revk/ESP32-GPS/PCB/Logger/production/bom.csv

Designator | Footprint | Quantity | Value | LCSC Part #
C1, C18, C26 | C_0805 | 3 | 100uF | C141660
C10, C11, C12, C13, C14, C15, C16, C17, C19, C21, C23, C24, C25, C3, C4, C6, C7, C8, C9 | C_0402 | 19 | 100nF
C2 | CP_EIA-7343-31_Kemet-D | 1 | C_Polarized | C106188
C20, C22 | C_0603 | 2 | 22uF
C5 | C_0402 | 1 | 1uF
D1, D20, D24, D3, D5, D6 | DFN1006-2L | 6 | ~ | C5137770
D10, D11, D12, D13, D14, D15, D16, D17, D18, D19, D21, D22, D23, D4, D7, D8, D9 | SMD1010 | 17 | XL-1010RGBC-WS2812B | C5349953
D2 | D_SOD-123 | 1 | MBR0530
J1 | JST_PH_S2B-PH-SM4-TB_1x02-1MP_P2.00mm_Horizontal | 1 | JST-PH-SM4-TB | C295747
J2 | USB-C-Socket-H | 1 | USB-C-Socket-V | C709357
J4 | AA-Pad | 1 | Reset
J6 | TF_PUSH | 1 | TF_PUSH | C393941
Q1, Q3 | SOT-23 | 2 | CJ2301 | C5224170
Q2 | SOT-23 | 1 | C179347 | C3034
R1, R15, R16, R17, R18, R19, R20, R4, R5, R6 | R_0402 | 10 | 10K
R10 | R_1218 | 1 | 1R 1W | C175540
R11, R7, R8, R9 | R_0402 | 4 | 100K 1% | C5139597
R2, R3 | R_0402 | 2 | 5K1
U1 | ESP32-S3-MINI-1 | 1 | ESP32-S3-MINI-1 | C3013941
U2 | LGA-16_3x3mm_P0.5mm_LayoutBorder3x5y | 1 | ~ | C15134
U3 | SOT-23-5 | 1 | TP4054 | C668215
U4 | SOT-23-5 | 1 | ME6211C33M5G-N | C82942
