revk/ESP32-GPS/PCB/L86/L86.stl

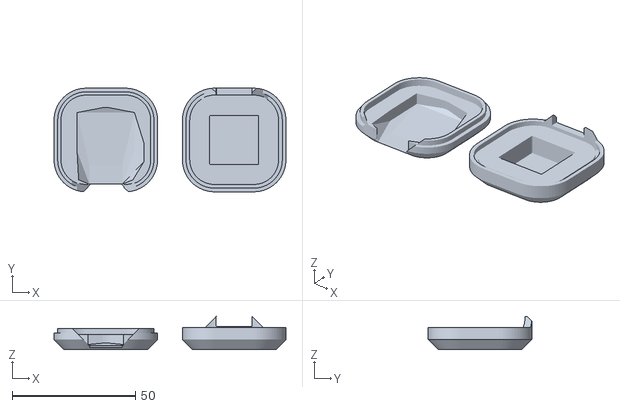
[picture p2: CAD file, 2024-01-20]
PCB/L86/L86.stl
94.0 x 42.0 x 13.4
