revk/ESP32-GPS/PCB/Logger/Logger.stl

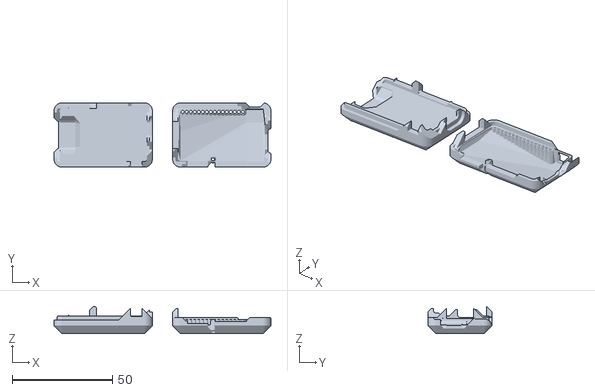
[picture p3: CAD file, 2024-01-20]
PCB/Logger/Logger.stl
108.0 x 32.0 x 13.6
