revk/ESP32-GPS/PCB/Logger/Logger.kicad_pcb

## KiCad design PCB/Logger/Logger.kicad_pcb (2026-02-13)

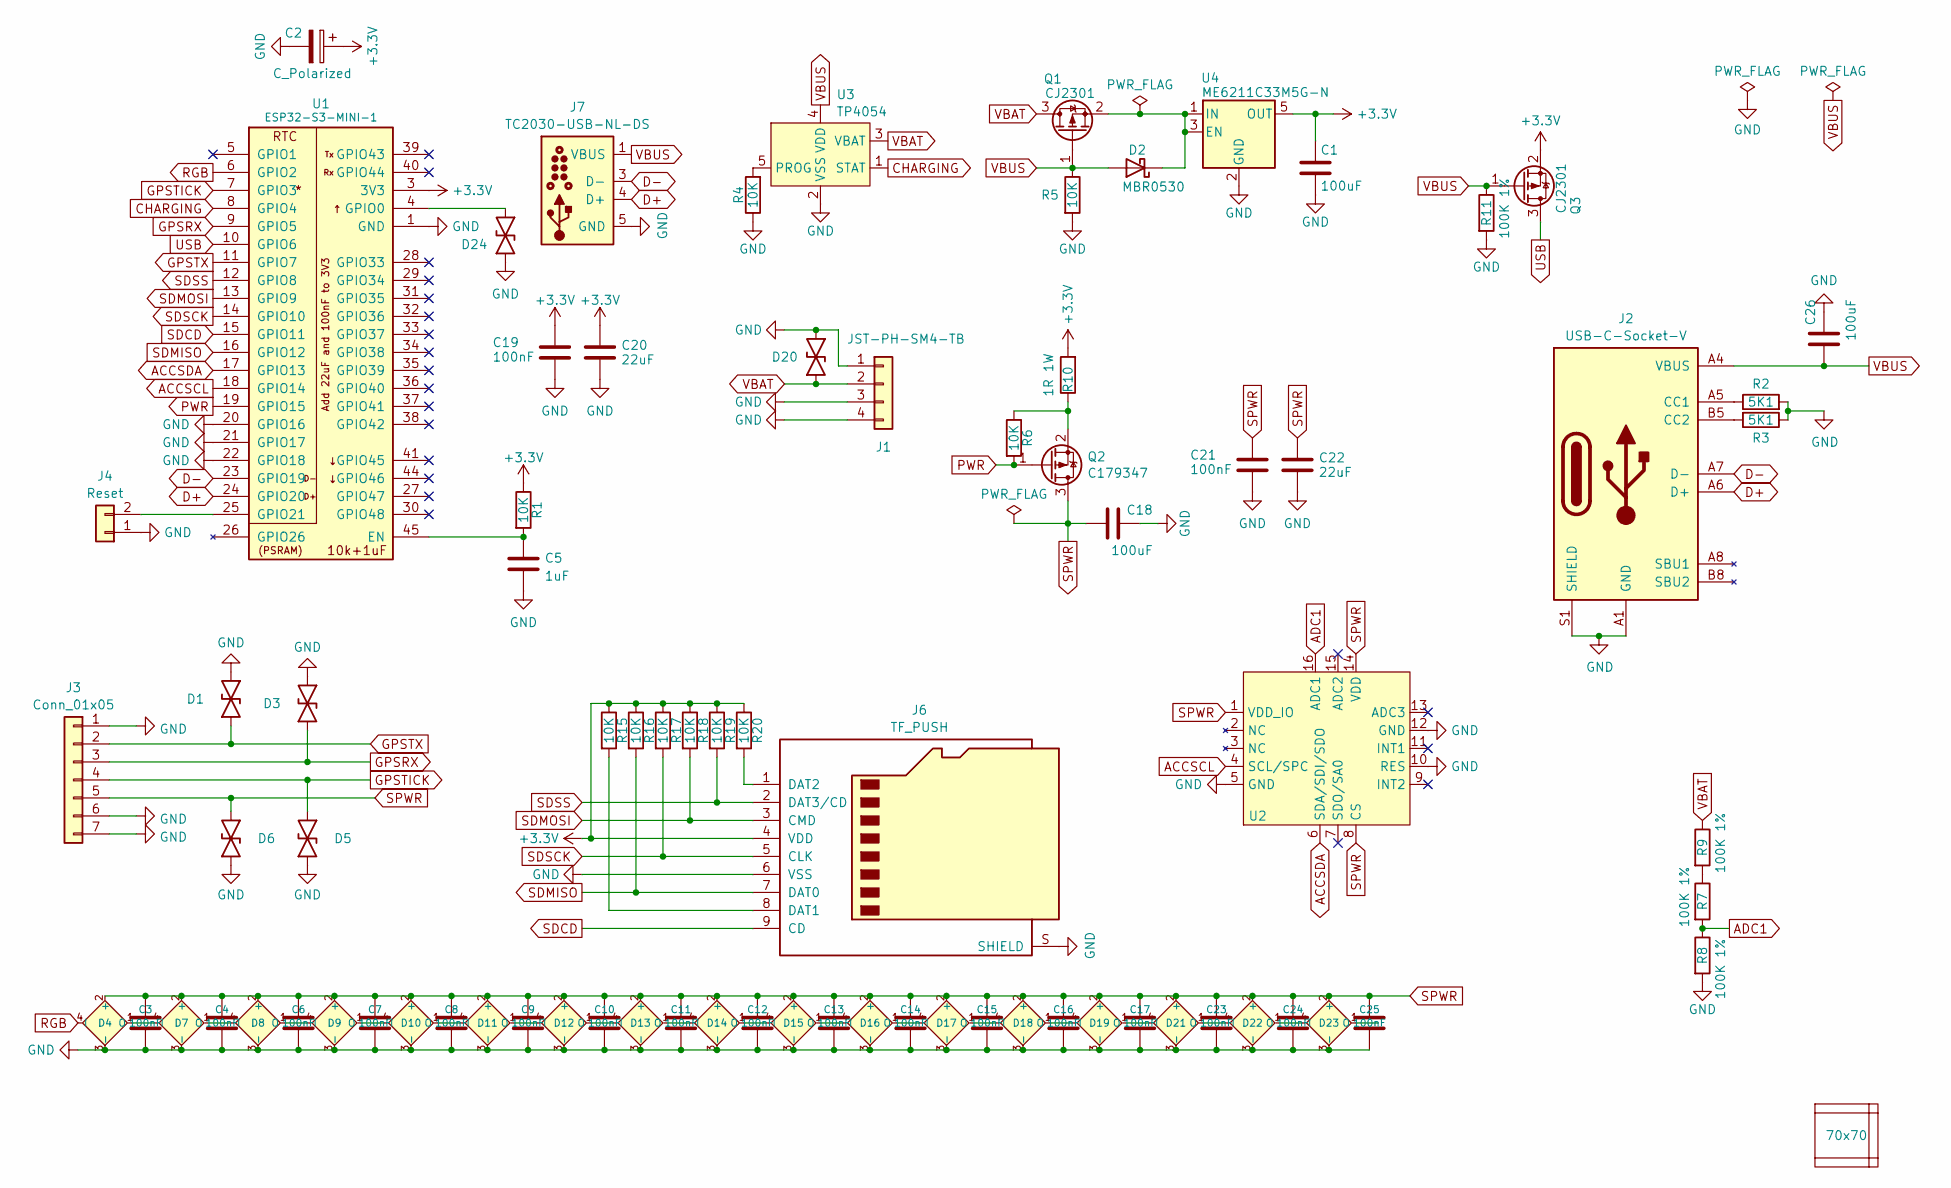
[picture p4: schematic Logger.kicad_sch, GPS reference]

Parts:
C1, C18, C26: 100uF; C_0805; MPN C141660
C2: C_Polarized; CP_EIA-7343-31_Kemet-D; MPN C106188
C3, C4, C6, C7, C8, C9, C10, C11, C12, C13, C14, C15, C16, C17, C19, C21, C23, C24, C25: 100nF; C_0402
C5: 1uF; C_0402
C20, C22: 22uF; C_0603
D1, D3, D5, D6, D20, D24: DFN1006-2L; MPN C5137770
D2: MBR0530; D_SOD-123; MPN C5204746
D4, D7, D8, D9, D10, D11, D12, D13, D14, D15, D16, D17, D18, D19, D21, D22, D23: XL-1010RGBC-WS2812B; SMD1010; MPN C5349953
J1: JST-PH-SM4-TB; JST_PH_S2B-PH-SM4-TB_1x02-1MP_P2.00mm_Horizontal; MPN C295747
J2: USB-C-Socket-V; USB-C-Socket-H; MPN C709357
J3: Conn_01x05; PTSM-HH-5-RA-SMD; Part Name PTSM 0,5/ 5-HH0-2,5-SMD WH R32
J4: Reset; AA-Pad
J6: TF_PUSH; MPN C393941
J7: TC2030-USB-NL-DS; Tag-Connect_TC2030-IDC-NL_2x03_P1.27mm_Vertical
PCB1: 70x70; PCB7070
Q1, Q3: CJ2301; SOT-23; MPN C5224170
Q2: C179347; SOT-23; MPN C3034
R1, R4, R5, R6, R15, R16, R17, R18, R19, R20: 10K; R_0402
R2, R3: 5K1; R_0402
R7, R8, R9, R11: 100K 1%; R_0402; MPN C5139597
R10: 1R 1W; R_1218; MPN C175540
U1: ESP32-S3-MINI-1; MPN C3013941
U2: LGA-16_3x3mm_P0.5mm_LayoutBorder3x5y; MPN C15134
U3: TP4054; SOT-23-5; MPN C668215
U4: ME6211C33M5G-N; SOT-23-5; MPN C82942
V1, V2, V4: VCUT70N

Connections:
+3.3V: C1.1, C2.1, C19.1, C20.1, J6.4 (VDD), Q3.2 (S), R1.1, R10.2, R15.1, R16.1, R17.1, R18.1, R19.1, R20.1, U1.3 (3V3), U4.5 (OUT)
ACCSCL: U1.18 (GPIO14), U2.4 (SCL/SPC)
ACCSDA: U1.17 (GPIO13), U2.6 (SDA/SDI/SDO)
ADC1: R7.2, R8.1, U2.16 (ADC1)
CHARGING: U1.8 (GPIO4), U3.1 (STAT)
D+: J2.A6 (D+), J2.B6 (D+), J7.4 (D+), U1.24 (GPIO20)
D-: J2.A7 (D-), J2.B7 (D-), J7.3 (D-), U1.23 (GPIO19)
GND: C1.2, C2.2, C3.2, C4.2, C5.2, C6.2, C7.2, C8.2, C9.2, C10.2, C11.2, C12.2, C13.2, C14.2, C15.2, C16.2, C17.2, C18.2, C19.2, C20.2, C21.2, C22.2, C23.2, C24.2, C25.2, C26.2, D1.1, D3.1, D4.3 (-), D5.1, D6.1, D7.3 (-), D8.3 (-), D9.3 (-), D10.3 (-), D11.3 (-), D12.3 (-), D13.3 (-), D14.3 (-), D15.3 (-), D16.3 (-), D17.3 (-), D18.3 (-), D19.3 (-), D20.1, D21.3 (-), D22.3 (-), D23.3 (-), D24.2, J1.1, J1.3, J1.4, J2.A1 (GND), J2.A12 (GND), J2.B1 (GND), J2.B12 (GND), J2.S1 (SHIELD), J3.1, J3.6, J3.7, J4.1, J6.6 (VSS), J6.S (SHIELD), J7.5 (GND), J7.6 (GND), R2.2, R3.1, R4.1, R5.2, R8.2, R11.2, U1.1 (GND), U1.2 (GND), U1.20 (GPIO16), U1.21 (GPIO17), U1.22 (GPIO18), U1.42 (GND), U1.43 (GND), U1.46 (GND), U1.47 (GND), U1.48 (GND), U1.49 (GND), U1.50 (GND), U1.51 (GND), U1.52 (GND), U1.53 (GND), U1.54 (GND), U1.55 (GND), U1.56 (GND), U1.57 (GND), U1.58 (GND), U1.59 (GND), U1.60 (GND), U1.61 (GND), U1.62 (GND), U1.63 (GND), U1.64 (GND), U1.65 (GND), U2.5 (GND), U2.10 (RES), U2.12 (GND), U3.2 (VSS), U4.2 (GND)
GPSRX: D3.2, J3.3, U1.9 (GPIO5)
GPSTICK: D5.2, J3.4, U1.7 (GPIO3)
GPSTX: D1.2, J3.2, U1.11 (GPIO7)
unnamed: D2.1 (K), Q1.2 (S), U4.1 (IN), U4.3 (EN)
unnamed: D4.1 (O), D7.4 (I)
unnamed: D7.1 (O), D8.4 (I)
unnamed: D8.1 (O), D9.4 (I)
unnamed: D9.1 (O), D10.4 (I)
unnamed: D10.1 (O), D11.4 (I)
unnamed: D11.1 (O), D12.4 (I)
unnamed: D12.1 (O), D13.4 (I)
unnamed: D13.1 (O), D14.4 (I)
unnamed: D14.1 (O), D15.4 (I)
unnamed: D15.1 (O), D16.4 (I)
unnamed: D16.1 (O), D17.4 (I)
unnamed: D17.1 (O), D18.4 (I)
unnamed: D18.1 (O), D19.4 (I)
unnamed: D19.1 (O), D21.4 (I)
unnamed: D21.1 (O), D22.4 (I)
unnamed: D22.1 (O), D23.4 (I)
unnamed: J2.A5 (CC1), R2.1
unnamed: J2.B5 (CC2), R3.2
unnamed: J4.2, U1.25 (GPIO21)
unnamed: J6.8 (DAT1), R15.2
unnamed: J6.1 (DAT2), R20.2
unnamed: Q2.2 (S), R6.1, R10.1
unnamed: R7.1, R9.2
unnamed: C5.1, R1.2, U1.45 (EN)
unnamed: D24.1, U1.4 (GPIO0)
unnamed: R4.2, U3.5 (PROG)
PWR: Q2.1 (G), R6.2, U1.19 (GPIO15)
RGB: D4.4 (I), U1.6 (GPIO2)
SDCD: J6.9 (CD), U1.15 (GPIO11)
SDMISO: J6.7 (DAT0), R16.2, U1.16 (GPIO12)
SDMOSI: J6.3 (CMD), R18.2, U1.13 (GPIO9)
SDSCK: J6.5 (CLK), R17.2, U1.14 (GPIO10)
SDSS: J6.2 (DAT3/CD), R19.2, U1.12 (GPIO8)
SPWR: C3.1, C4.1, C6.1, C7.1, C8.1, C9.1, C10.1, C11.1, C12.1, C13.1, C14.1, C15.1, C16.1, C17.1, C18.1, C21.1, C22.1, C23.1, C24.1, C25.1, D4.2 (+), D6.2, D7.2 (+), D8.2 (+), D9.2 (+), D10.2 (+), D11.2 (+), D12.2 (+), D13.2 (+), D14.2 (+), D15.2 (+), D16.2 (+), D17.2 (+), D18.2 (+), D19.2 (+), D21.2 (+), D22.2 (+), D23.2 (+), J3.5, Q2.3 (D), U2.1 (VDD_IO), U2.8 (CS), U2.14 (VDD)
USB: Q3.3 (D), U1.10 (GPIO6)
VBAT: D20.2, J1.2, Q1.3 (D), R9.1, U3.3 (VBAT)
VBUS: C26.1, D2.2 (A), J2.A4 (VBUS), J2.A9 (VBUS), J2.B4 (VBUS), J2.B9 (VBUS), J7.1 (VBUS), J7.2 (VBUS), Q1.1 (G), Q3.1 (G), R5.1, R11.1, U3.4 (VDD)

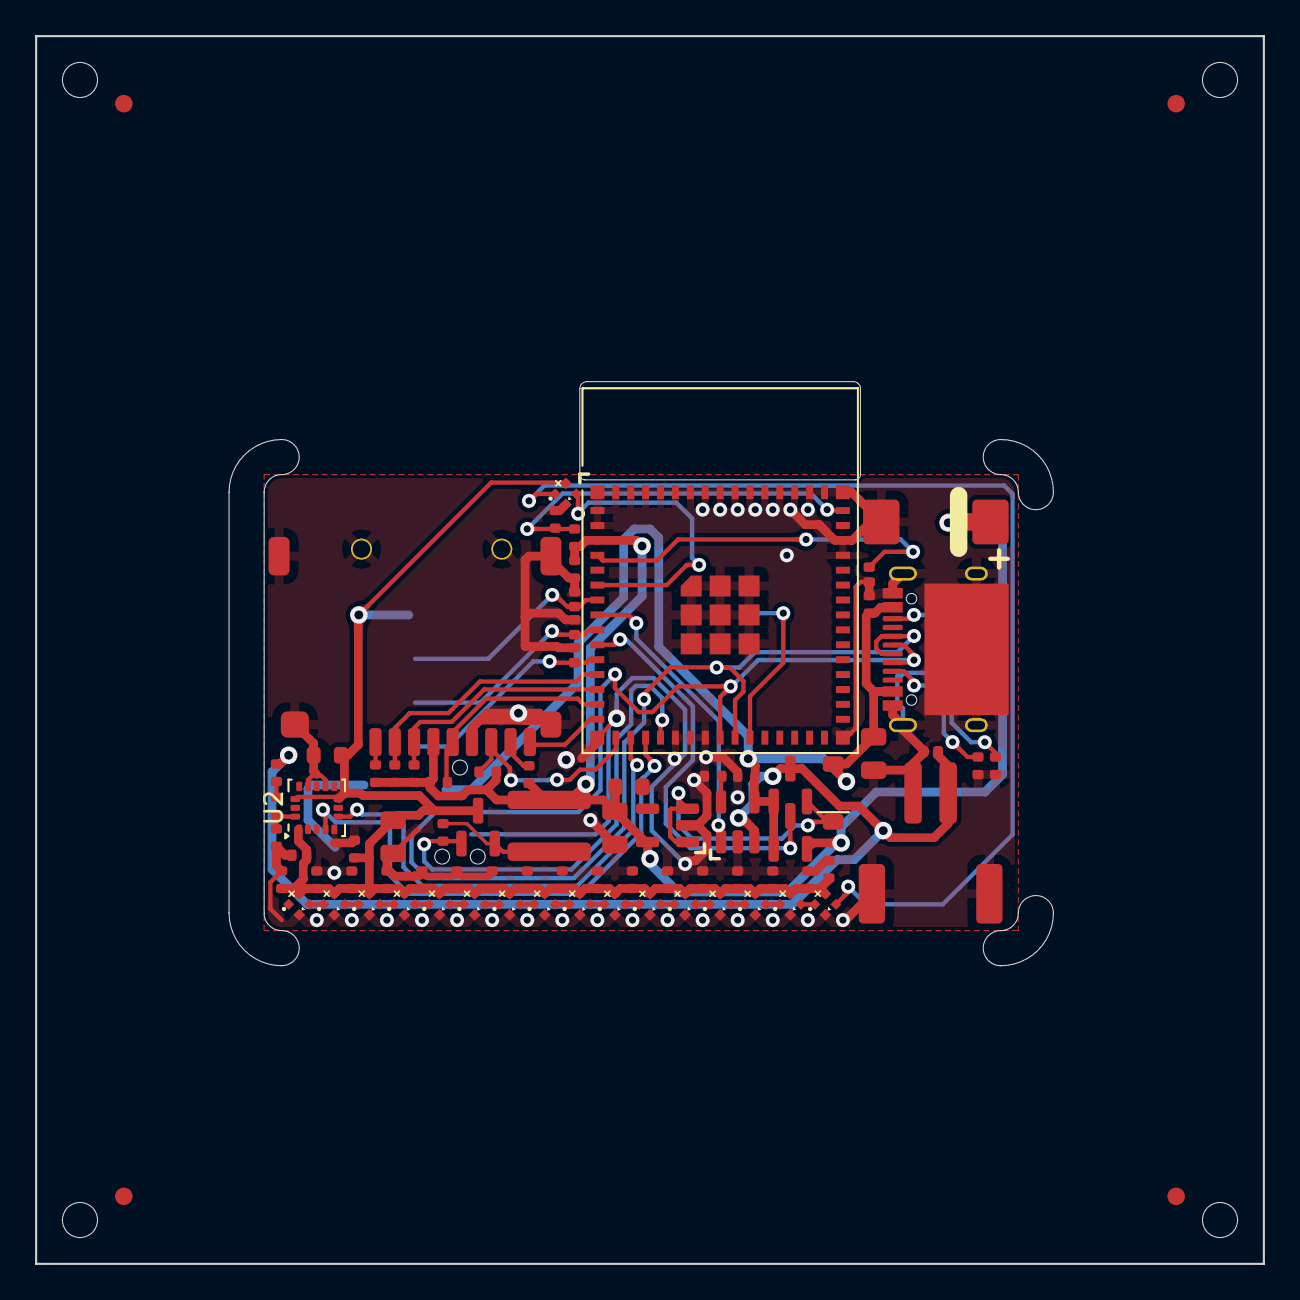
[picture p5: board Logger.kicad_pcb from above]

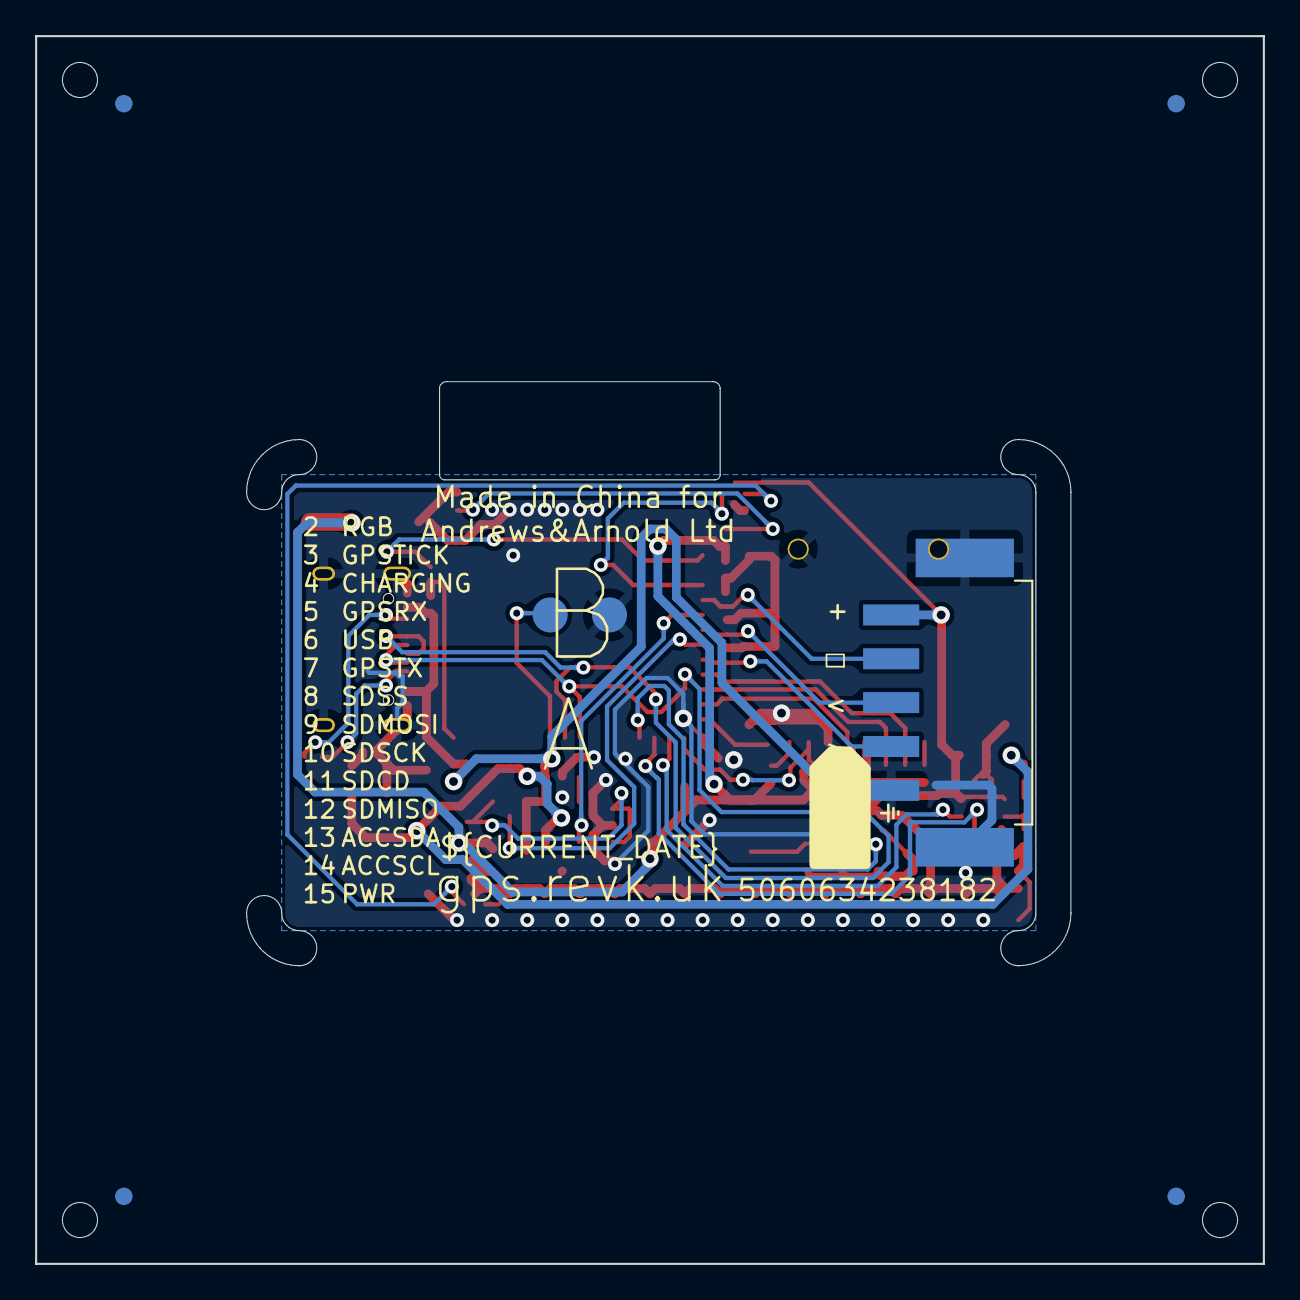
[picture p6: board Logger.kicad_pcb from below]

Board: 2 copper layers, 70.0 x 70.0 mm, 84 parts (4 on the bottom side), 49 nets.
