revk/ESP32-GPS/PCB/L86/L86.kicad_pcb

## KiCad design PCB/L86/L86.kicad_pcb (2026-02-13)

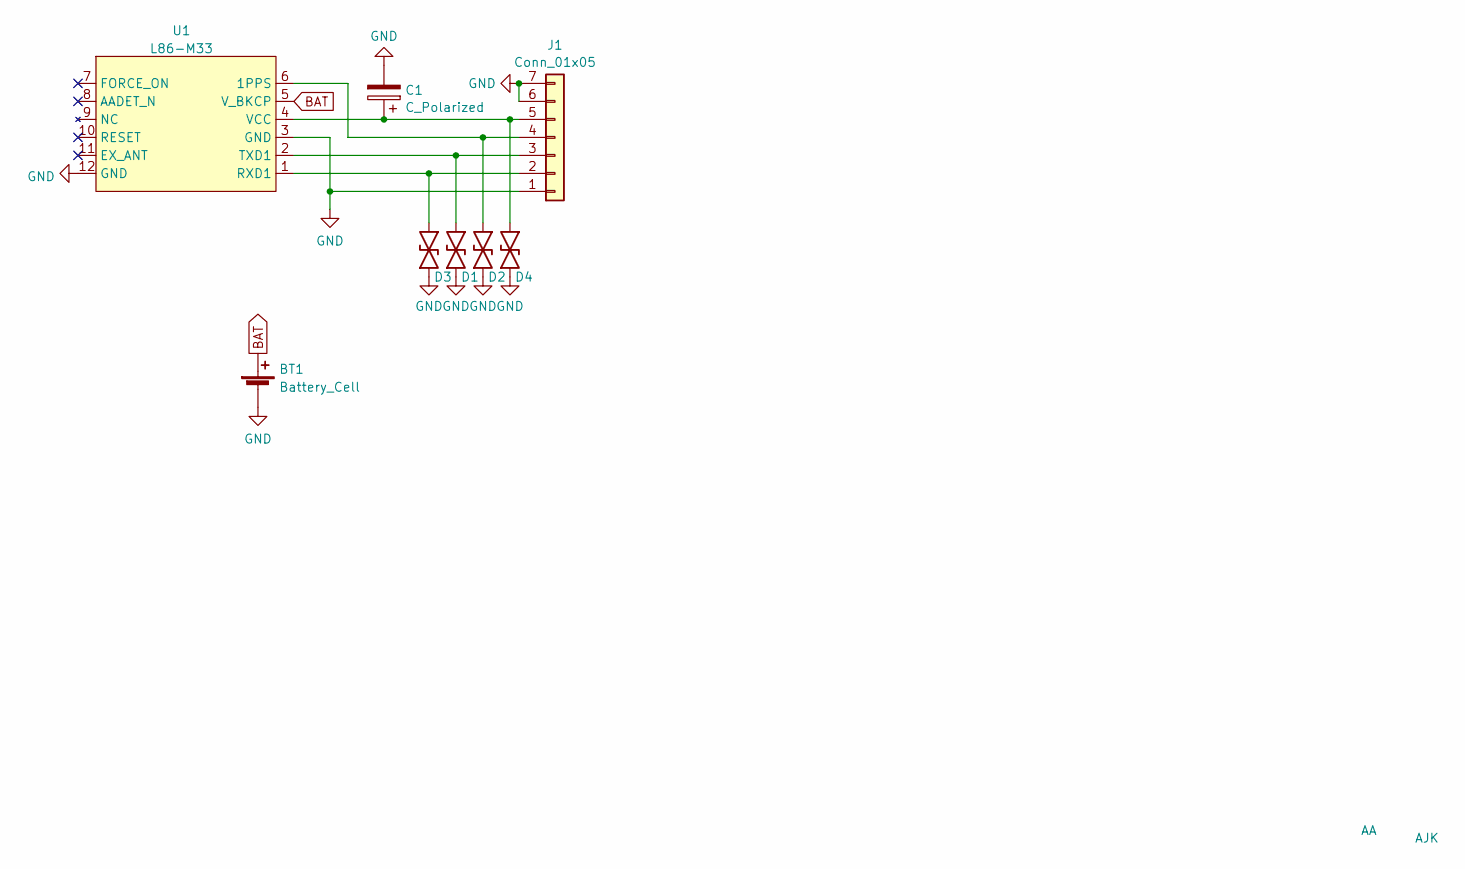
[picture p7: schematic L86.kicad_sch, GPS reference]

Parts:
BT1: Battery_Cell; Battery-Holder-2032
C1: C_Polarized; CP_EIA-7343-31_Kemet-D; MPN C106188
D1, D2, D3, D4: DFN1006-2L; MPN C5137770
J1: Conn_01x05; PTSM-HH-5-RA-P-SMD; Part name PTSM 0,5/ 5-HHI0-2,5SMDWH
Logo1: AA
Logo2: AJK
U1: L86-M33

Connections:
BAT: BT1.1 (+), U1.5 (V_BKCP)
GND: BT1.2 (-), C1.2, D1.2, D2.2, D3.2, D4.2, J1.1, J1.6, J1.7, U1.3 (GND), U1.12 (GND)
unnamed: D3.1, J1.2, U1.1 (RXD1)
unnamed: D1.1, J1.3, U1.2 (TXD1)
unnamed: D2.1, J1.4, U1.6 (1PPS)
unnamed: C1.1, D4.1, J1.5, U1.4 (VCC)

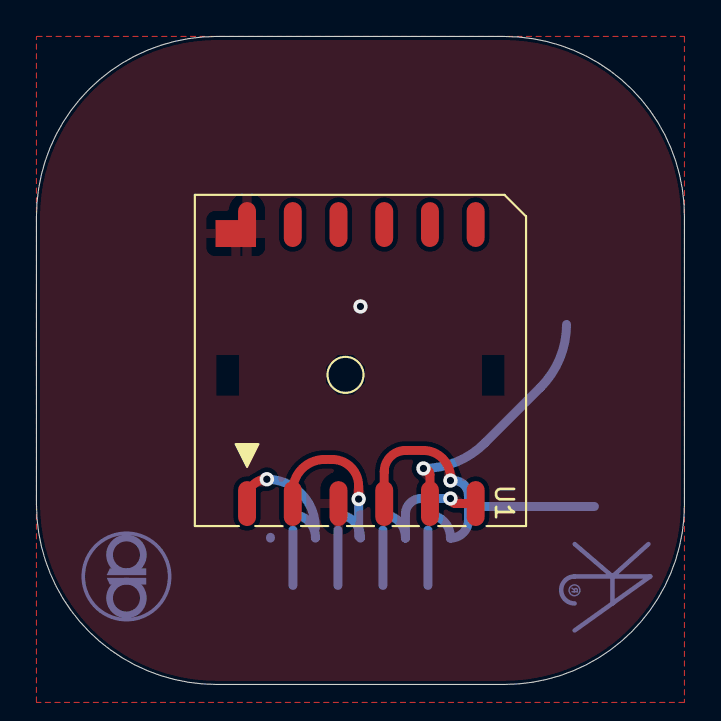
[picture p8: board L86.kicad_pcb from above]

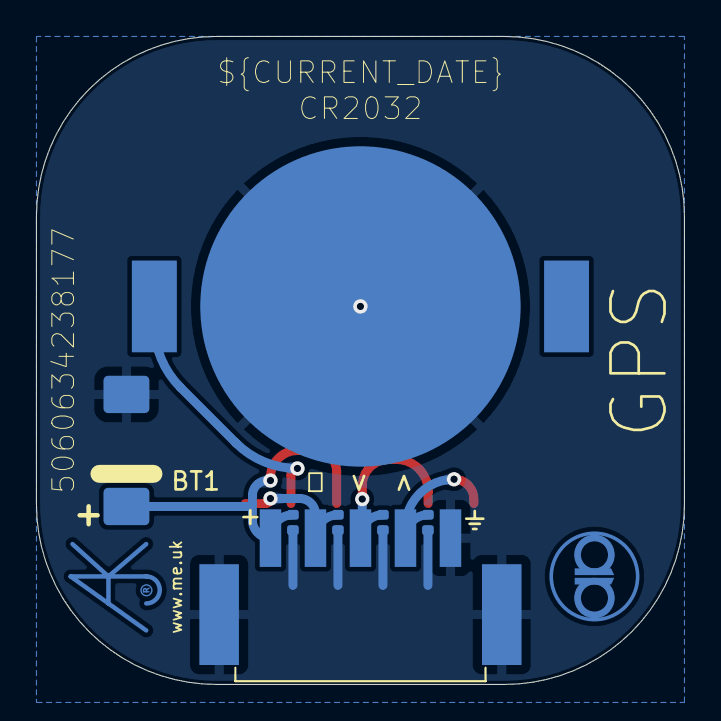
[picture p9: board L86.kicad_pcb from below]

Board: 2 copper layers, 36.0 x 36.0 mm, 10 parts (9 on the bottom side), 6 nets.
