revk/ESP32-GPS/PCB/Display/Display.kicad_pcb

## KiCad design PCB/Display/Display.kicad_pcb (2026-02-13)

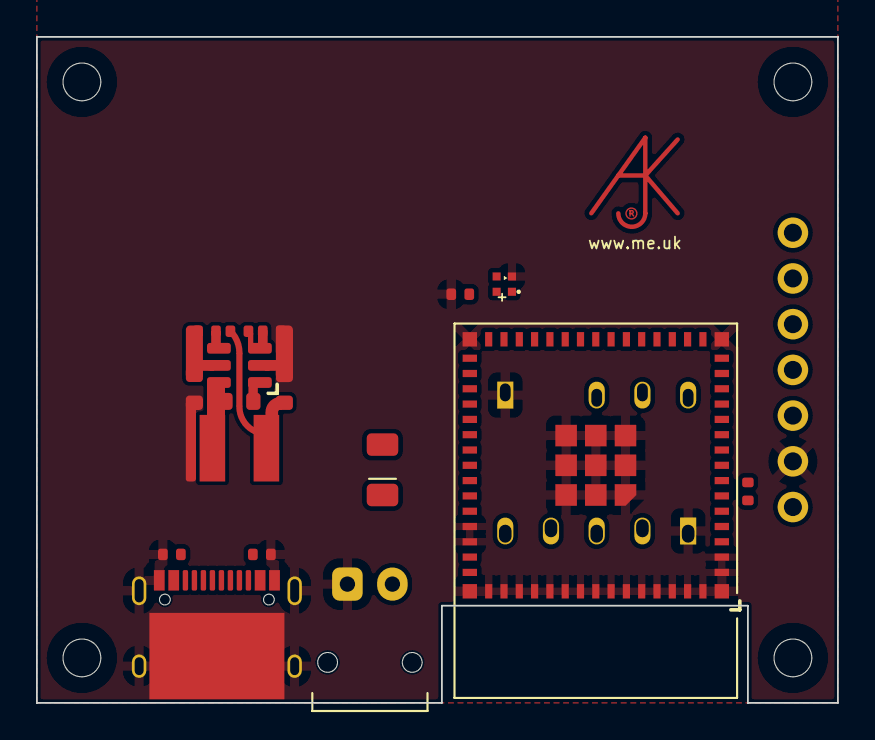
[picture p10: board Display.kicad_pcb from above]

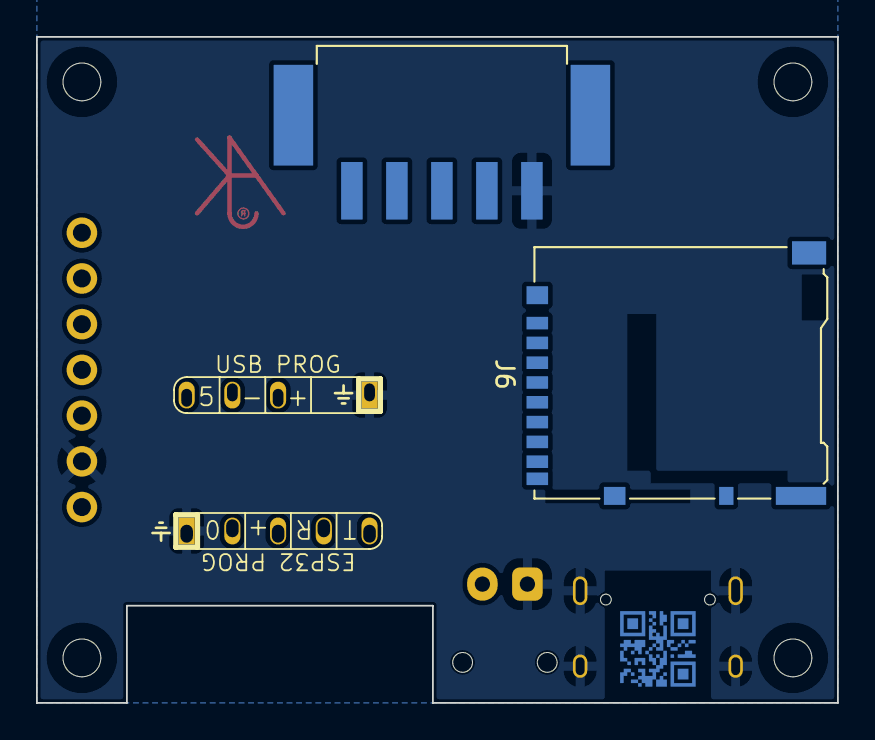
[picture p11: board Display.kicad_pcb from below]

Board: 2 copper layers, 44.5 x 37.0 mm, 24 parts (5 on the bottom side), 21 nets, no tracks yet.

Parts:
C5: 1uF; C_0402
C6: 10uF 50V; C_0603_
C7: 10uF 6.3V; C_0603_
C8: 100nF; C_0603_
D1: D; D_1206
D4: XL-1010RGBC-WS2812B; SMD1010
J1: POWER; PTSM-HH1-2-RA
J2: USB-C-Socket-V; USB-C-Socket-H
J3: Conn_01x05; PTSM-HH-5-RA-SMD
J4: Shelly
J5: USB-PROG
J6: DM3AT-SF-PEJM5; microSD_HC_Hirose_DM3AT-SF-PEJM5
L2: 10uH; L_4x4_
Logo2: AJK
M1: OLED1.5-RGB
R1: 10K; R_0402
R2, R3: 5K1; R_0402
R13: 124k; R_0402_
R14: 40k2; R_0402_
R15: 1M; R_0402_
U1: ESP32-S3-MINI-1
U2: MD8942; SOT-23-6-MD8942
U5: QR; QR-SS

Connections:
+3V3: D4.2 (+), J3.5, J4.3 (3V3), M1.1 (Vcc), R1.1, U1.3 (3V3), U2.8 (VOUT)
D+: J2.A6 (D+), J2.B6 (D+), J5.3 (D+), U1.24 (GPIO20)
D-: J2.A7 (D-), J2.B7 (D-), J5.2 (D-), U1.23 (GPIO19)
DC: D1.1 (K), J1.2 (DC), U2.5 (VIN)
GND: C5.2, D4.3 (-), J1.1 (GND), J2.A1 (GND), J2.A12 (GND), J2.B1 (GND), J2.B12 (GND), J2.S1 (SHIELD), J3.1, J4.1 (GND), J5.4 (GND), M1.2 (GND), R2.2, R3.1, U1.1 (GND), U1.2 (GND), U1.42 (GND), U1.43 (GND), U1.46 (GND), U1.47 (GND), U1.48 (GND), U1.49 (GND), U1.50 (GND), U1.51 (GND), U1.52 (GND), U1.53 (GND), U1.54 (GND), U1.55 (GND), U1.56 (GND), U1.57 (GND), U1.58 (GND), U1.59 (GND), U1.60 (GND), U1.61 (GND), U1.62 (GND), U1.63 (GND), U1.64 (GND), U1.65 (GND), U2.2 (GND), U2.7 (GND)
GPSRX: J3.2, U1.36 (GPIO40)
GPSTICK: J3.4, U1.37 (GPIO41)
GPSTX: J3.3, U1.33 (GPIO37)
unnamed: J2.A5 (CC1), R2.1
unnamed: J2.B5 (CC2), R3.2
unnamed: J4.2 (0), U1.4 (GPIO0)
unnamed: J4.4 (Rx), U1.40 (GPIO44)
unnamed: J4.5 (Tx), U1.39 (GPIO43)
unnamed: C5.1, R1.2, U1.45 (EN)
OLED-CS: M1.5 (CS), U1.35 (GPIO39)
OLED-DC: M1.6 (DC), U1.19 (GPIO15)
OLED-MOSI: M1.3 (DIN), U1.16 (GPIO12)
OLED-RST: M1.7 (RST), U1.18 (GPIO14)
OLED-SCK: M1.4 (CLK), U1.34 (GPIO38)
RGB: D4.4 (I), U1.28 (GPIO33)
VBUS: D1.2 (A), J2.A4 (VBUS), J2.A9 (VBUS), J2.B4 (VBUS), J2.B9 (VBUS), J5.1 (VBUS)
