revk/ESP32-GPS/PCB/Glider/Glider.kicad_pcb

## KiCad design PCB/Glider/Glider.kicad_pcb (2024-01-01)

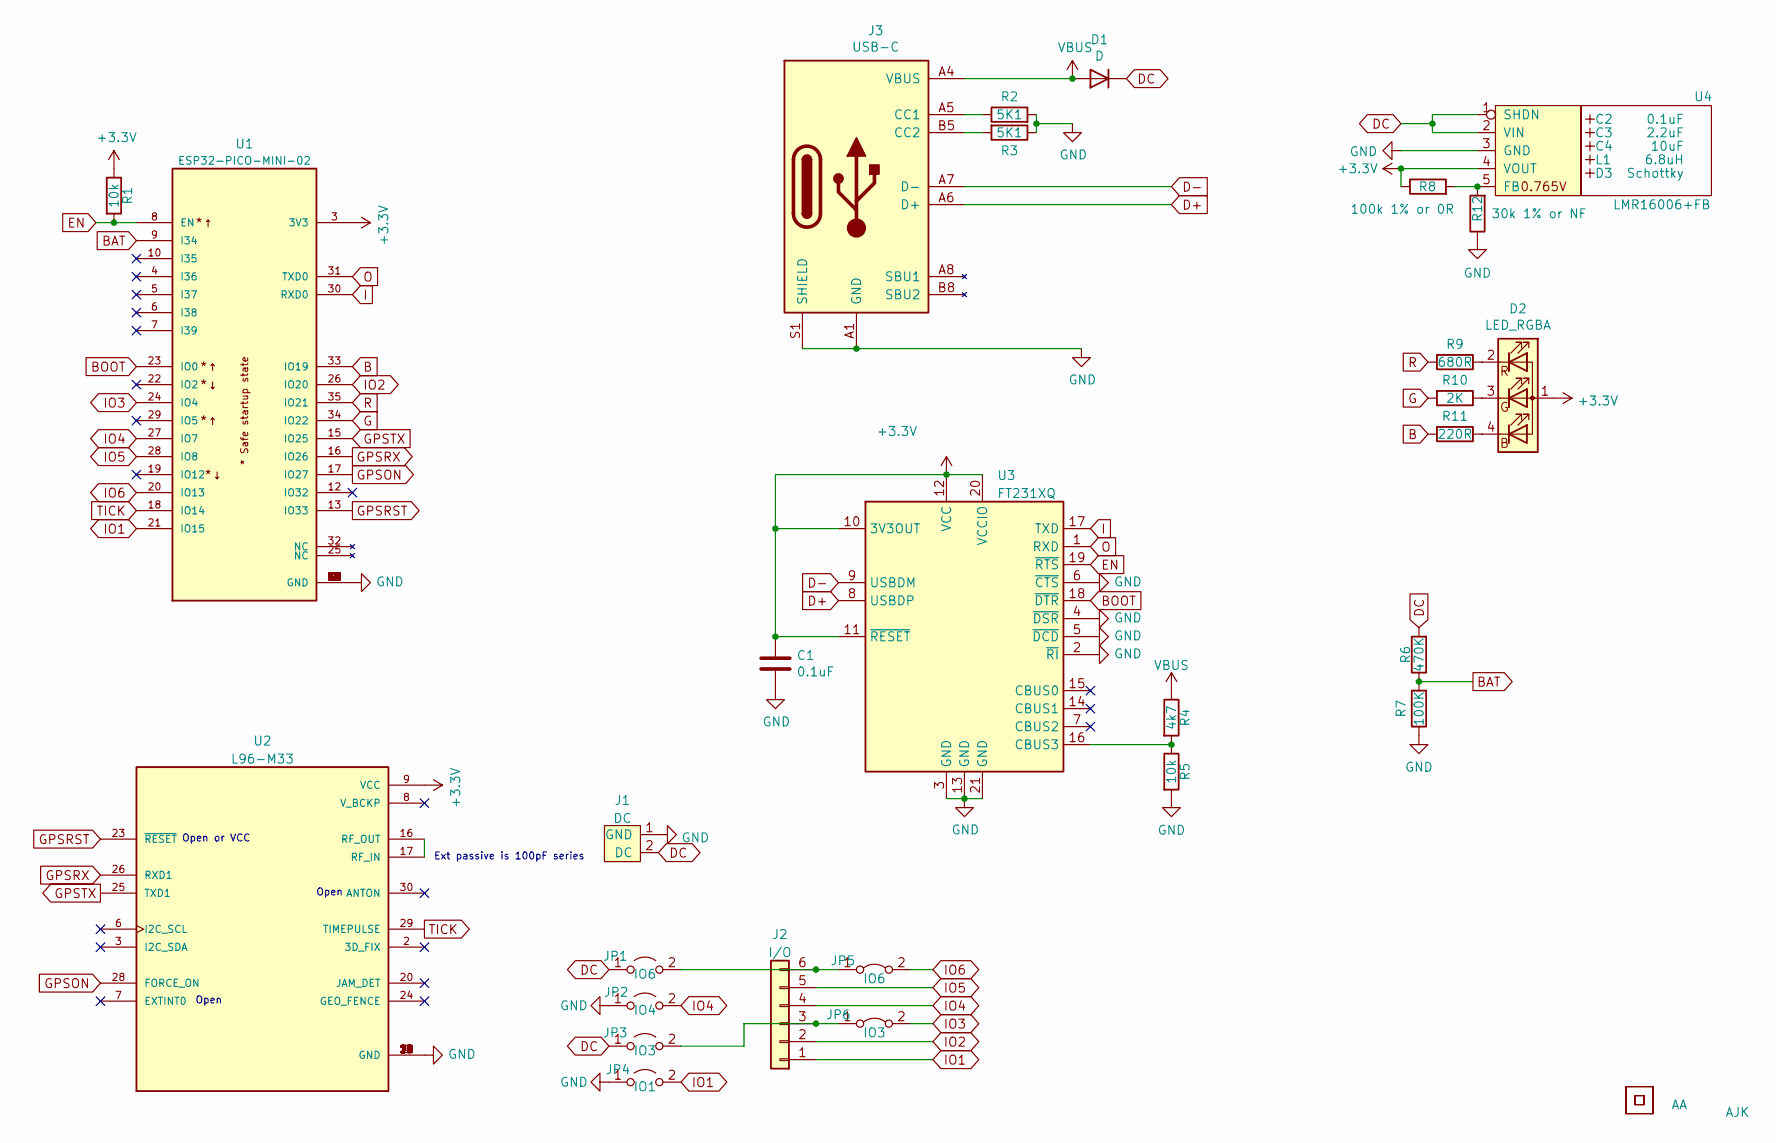
[picture p12: schematic Glider.kicad_sch, GPS / Glider control board]

Parts:
C1: 0.1uF; C_0603
C2: 0.1uF; Hidden
C3: 2.2uF; Hidden
C4: 10uF; Hidden
D1: D; D_1206_3216Metric
D2: LED_RGBA; LED-RGB-1.6x1.6
D3: Schottky; Hidden; Part No CD1206-B2100
J1: DC; Molex_MiniSPOX_H2RA
J2: I/O; Molex_MiniSPOX_H6RA
J3: USB-C; USC16-TR-Round
JP1: IO6; Pad_1206_0805_Open
JP2: IO4; Pad_1206_0805_Open
JP3: IO3; Pad_1206_0805_Open
JP4: IO1; Pad_1206_0805_Open
JP5: IO6; Pad_1206_0805_Bridged
JP6: IO3; Pad_1206_0805_Bridged
L1: 6.8uH; Hidden; Part No TYA4020
Logo1: AA
Logo2: AJK
R1, R5: 10k; R_0603
R2, R3: 5K1; R_0603
R4: 4k7; R_0603
R6: 470K; R_0603
R7: 100K; R_0603
R8: 100k 1% or 0R; R_0603
R9: 680R; R_0603
R10: 2K; R_0603
R11: 220R; R_0603
R12: 30k 1% or NF; R_0603
U1: ESP32-PICO-MINI-02; PARTREV v1.0
U2: L96-M33
U3: FT231XQ; QFN-20-1EP_4x4mm_P0.5mm_EP2.5x2.5mm
U4: LMR16006+FB; RegulatorBlockFB; Part No LMR16006YQ3
U5: QR; QR-SS

Connections:
+3V3: C1.1, D2.1 (A), R1.1, R8.1, U1.3 (3V3), U2.9 (VCC), U3.10 (3V3OUT), U3.11 (~RESET), U3.12 (VCC), U3.20 (VCCIO), U4.4 (VOUT)
B: R11.2, U1.33 (IO19)
BAT: R6.1, R7.2, U1.9 (I34)
BOOT: U1.23 (IO0), U3.18 (~DTR)
D+: J3.A6 (D+), J3.B6 (D+), U3.8 (USBDP)
D-: J3.A7 (D-), J3.B7 (D-), U3.9 (USBDM)
DC: D1.1 (K), J1.2 (DC), JP1.1 (A), JP3.1 (A), R6.2, U4.1 (SHDN), U4.2 (VIN)
EN: R1.2, U1.8 (EN), U3.19 (~RTS)
G: R10.2, U1.34 (IO22)
GND: C1.2, J1.1 (GND), J3.A1 (GND), J3.A12 (GND), J3.B1 (GND), J3.B12 (GND), J3.S1 (SHIELD), JP2.1 (A), JP4.1 (A), R2.2, R3.1, R5.2, R7.1, R12.1, U1.1 (GND), U1.2 (GND), U1.11 (GND), U1.14 (GND), U1.36 (GND), U1.37 (GND), U1.38 (GND), U1.39 (GND), U1.40 (GND), U1.41 (GND), U1.42 (GND), U1.43 (GND), U1.44 (GND), U1.45 (GND), U1.46 (GND), U1.47 (GND), U1.48 (GND), U1.49 (GND), U1.50 (GND), U1.51 (GND), U1.52 (GND), U1.53 (GND), U2.4 (GND), U2.5 (GND), U2.10 (GND), U2.11 (GND), U2.12 (GND), U2.13 (GND), U2.14 (GND), U2.15 (GND), U2.18 (GND), U2.19 (GND), U2.21 (GND), U2.22 (GND), U2.27 (GND), U2.31 (GND), U3.2 (~RI), U3.3 (GND), U3.4 (~DSR), U3.5 (~DCD), U3.6 (~CTS), U3.13 (GND), U3.21 (GND), U4.3 (GND)
GPSON: U1.17 (IO27), U2.28 (FORCE_ON)
GPSRST: U1.13 (IO33), U2.23 (~RESET)
GPSRX: U1.16 (IO26), U2.26 (RXD1)
GPSTX: U1.15 (IO25), U2.25 (TXD1)
I: U1.30 (RXD0), U3.17 (TXD)
IO1: J2.1, JP4.2 (B), U1.21 (IO15)
IO2: J2.2, U1.26 (IO20)
IO3: JP6.2 (B), U1.24 (IO4)
IO4: J2.4, JP2.2 (B), U1.27 (IO7)
IO5: J2.5, U1.28 (IO8)
IO6: JP5.2 (B), U1.20 (IO13)
unnamed: D2.2 (RK), R9.1
unnamed: D2.3 (GK), R10.1
unnamed: D2.4 (BK), R11.1
unnamed: J2.3, JP3.2 (B), JP6.1 (A)
unnamed: J2.6, JP1.2 (B), JP5.1 (A)
unnamed: J3.A5 (CC1), R2.1
unnamed: J3.B5 (CC2), R3.2
unnamed: R4.2, R5.1, U3.16 (CBUS3)
unnamed: R8.2, R12.2, U4.5 (FB)
unnamed: U2.16 (RF_OUT), U2.17 (RF_IN)
O: U1.31 (TXD0), U3.1 (RXD)
R: R9.2, U1.35 (IO21)
TICK: U1.18 (IO14), U2.29 (TIMEPULSE)
VBUS: D1.2 (A), J3.A4 (VBUS), J3.A9 (VBUS), J3.B4 (VBUS), J3.B9 (VBUS), R4.1

Notes on the sheet:
Open
Ext passive is 100pF series
Open or VCC

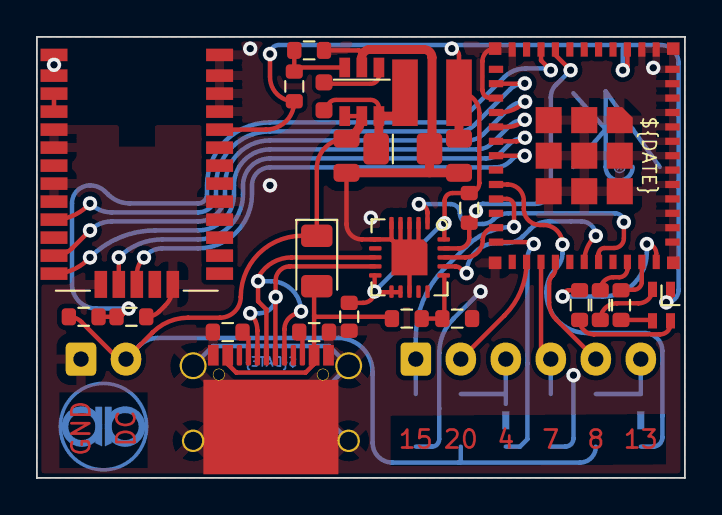
[picture p13: board Glider.kicad_pcb from above]

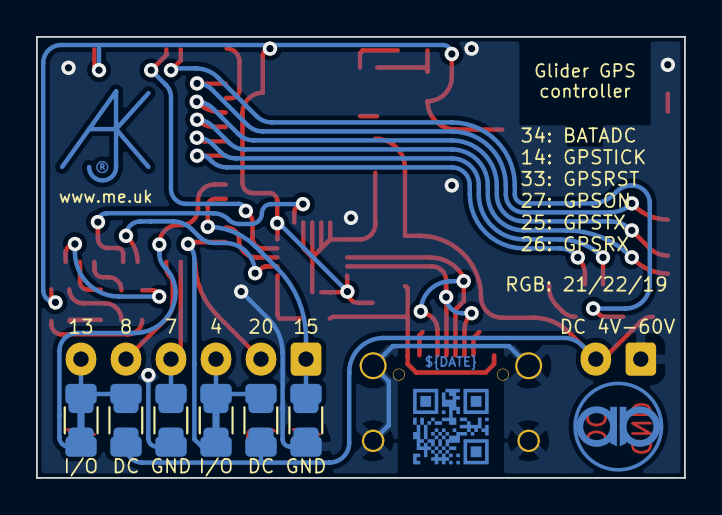
[picture p14: board Glider.kicad_pcb from below]

Board: 2 copper layers, 36.0 x 24.5 mm, 36 parts (9 on the bottom side), 35 nets.
