revk/ESP32-GPS/makepostcodes.c

// Make postcode database

#include <stdio.h>
#include <string.h>
#include <popt.h>
#include <time.h>
#include <sys/time.h>
#include <stdlib.h>
#include <ctype.h>
#include <err.h>
#include "ostn02.h"

#define	SCALE	100000          // Scale lat/lon to E/N
#define	GRID	1000            // Grid squares
#define	RANGE	5000            // Max to postcode
#define	MAGIC	20240122        // File magic number

// Postcode file format
// Initial, LE 32 bit signed quantities
// - MAGIC
// - SCALE
// - GRID
// - BASEE
// - BASEN
// - GRIDWIDTH
// - GRIDHEIGHT
// Then a grid, HEIGHT rows of WIDTH columns, plus 1, each a position reference to records
// Records (all in grid and nearest entries that are not in grid))
// - E (LE 32 bit)
// - N (LE 32 bit)
// - postcode (8 bytes, null terminated, no space)

void
writeu32 (unsigned int i)
{                               // LE
   putchar (i);
   putchar (i >> 8);
   putchar (i >> 16);
   putchar (i >> 24);
}

int debug = 0;

typedef struct postcode_s postcode_t;
struct postcode_s
{
   postcode_t *next;
   const char *postcode;
   int e,
     n;
};

// Blocks to speed up search
// 8W-2E 49N-61N
#define	BLOCK	RANGE
#define BLOCKE	(-8*SCALE)
#define BLOCKN	(49*SCALE)
#define	BLOCKW	(10*SCALE/BLOCK)
#define	BLOCKH	(12*SCALE/BLOCK)
postcode_t *postcodes[BLOCKW][BLOCKH] = { 0 };

#if BLOCK < RANGE
#error BLOCK too small
#endif

int
main (int argc, const char *argv[])
{
   // Load CSVs
   if (argc <= 1)
      errx (1, "List CSV files");
   int basee = 0,
      maxe = 0,
      basen = 0,
      maxn = 0,
      total = 0;
   for (int n = 1; n < argc; n++)
   {
      char *line = NULL;
      size_t linem = 0;
      FILE *i = fopen (argv[n], "r");
      if (!i)
         err (1, "Cannot open %s", argv[n]);
      ssize_t l = 0;
      while ((l = getline (&line, &linem, i)) >= 0)
      {
         char *postcode = line,
            *p = postcode;
         if (*postcode == '"')
         {
            p = ++postcode;
            while (*p && *p != '"')
               p++;
            if (*p)
               *p++ = 0;
            if (*p == ',')
               p++;
         }
         while (*p && *p != ',')
            p++;                // size
         if (*p)
            p++;
         int e = atoi (p);
         while (*p && *p != ',')
            p++;                // e
         if (*p)
            p++;
         int n = atoi (p);
         int l = strlen (postcode);
         if (l >= 6 && postcode[l - 4] == ' ' && e && n)
         {
            long double lat = 0,
               lon = 0;
            OSTN02_EN2LL (e, n, &lat, &lon, NULL);
            int E = lon * SCALE;
            int N = lat * SCALE;
            int x = (E - BLOCKE) / BLOCK,
               y = (N - BLOCKN) / BLOCK;
            if (x >= 0 && y >= 0 && x < BLOCKW && y < BLOCKH)
            {
               total++;
               memmove (postcode + l - 4, postcode + l - 3, 4); // Remove space
               postcode_t *new = malloc (sizeof (*new));
               if (!new)
                  errx (1, "malloc");
               new->postcode = strdup (postcode);
               new->e = E;
               new->n = N;
               new->next = postcodes[x][y];
               postcodes[x][y] = new;
               if (!basee || basee > E)
                  basee = E;
               if (maxe < E)
                  maxe = E;
               if (!basen || basen > N)
                  basen = N;
               if (maxn < N)
                  maxn = N;
            } else
               warnx ("%s %.9Lf/%.9Lf outside (%d/%d)", postcode, lat, lon, x, y);
         }
         //else warnx ("%s %d/%d %d/%d %d/%d", postcode, e, n, x, y, BLOCKW, BLOCKH);
      }
      fclose (i);
      free (line);
   }
   basee = basee / GRID * GRID;
   if (basee < 0)
      basee -= GRID;
   basen = basen / GRID * GRID;
   if (basen < 0)
      basen -= GRID;
   maxe = (maxe + GRID - 1) / GRID * GRID;
   maxn = (maxn + GRID - 1) / GRID * GRID;
   int gridw = (maxe - basee) / GRID;
   int gridh = (maxn - basen) / GRID;
   warnx ("E %d-%d N %d-%d total=%d grid %d/%d", basee, maxe, basen, maxn, total, gridw, gridh);
   // Generate postcode file
   // Header
   writeu32 (MAGIC);
   writeu32 (SCALE);
   writeu32 (GRID);
   writeu32 (basee);
   writeu32 (basen);
   writeu32 (gridw);
   writeu32 (gridh);
   int pos = 0;
   postcode_t *list = NULL,
      *liste = NULL;
   int maxcount = 0;
   for (int y = 0; y < gridh; y++)
   {
      int bn = basen + y * GRID,
         tn = bn + GRID - 1;
      for (int x = 0; x < gridw; x++)
      {
         writeu32 (pos);
         int le = basee + x * GRID,
            re = le + GRID - 1;
         int count = 0;
         postcode_t *dedup = liste;
         void add (postcode_t * p, int e, int n)
         {
            if (!p)
               return;
            for (postcode_t * d = dedup; d; d = d->next)
               if (d->postcode == p->postcode)
                  return;
            //warnx ("Add %7d %-7s %06d/%07d for %06d/%07d %d", pos, p->postcode, p->e, p->n, e, n, count);
            postcode_t *new = malloc (sizeof (*new));
            if (!new)
               errx (1, "malloc");
            new->e = p->e;
            new->n = p->n;
            new->postcode = p->postcode;
            new->next = NULL;
            if (!liste)
               dedup = list = new;
            else
               liste->next = new;
            liste = new;
            pos++;
            count++;
         }
         postcode_t *find (int e, int n)
         {
            long long best = 0;
            postcode_t *found = NULL;
            for (int x = (e - BLOCKE) / BLOCK - 1; x <= (e - BLOCKE) / BLOCK + 1; x++)
            {
               if (x < 0 || x >= BLOCKW)
                  continue;
               for (int y = (n - BLOCKN) / BLOCK - 1; y <= (n - BLOCKN) / BLOCK + 1; y++)
               {
                  if (y < 0 || y >= BLOCKH)
                     continue;
                  for (postcode_t * p = postcodes[x][y]; p; p = p->next)
                  {
                     long long d =
                        (long long) (p->e - e) * (long long) (p->e - e) + (long long) (p->n - n) * (long long) (p->n - n);
                     if (!found || d < best)
                     {
                        best = d;
                        found = p;
                     }
                  }
               }
            }
            if (best > (long long) RANGE * RANGE)
               return NULL;
            add (found, e, n);
            return found;
         }
         void edge (postcode_t * p1, int e1, int n1, postcode_t * p2, int e2, int n2)
         {
            if (p1 == p2)
               return;
            if (e1 + 2 >= e2 && n1 + 2 >= n2)
               return;
            int em = (e1 + e2) / 2,
               nm = (n1 + n2) / 2;
            postcode_t *m = find (em, nm);
            edge (p1, e1, n1, m, em, nm);
            edge (m, em, nm, p2, e2, n2);
         }
         postcode_t *lb = find (le, bn);        // Corners
         postcode_t *rb = find (re, bn);
         postcode_t *lt = find (le, tn);
         postcode_t *rt = find (re, tn);
         edge (lb, le, bn, rb, re, bn);
         edge (lt, le, tn, rt, re, tn);
         edge (lb, le, bn, lt, le, tn);
         edge (rb, re, bn, rt, re, tn);
         // In grid
         for (postcode_t * f = postcodes[(le - BLOCKE) / BLOCK][(bn - BLOCKN) / BLOCK]; f; f = f->next)
            if (f->n >= bn && f->n <= tn && f->e >= le && f->e <= re)
               add (f, (le + re) / 2, (bn + tn) / 2);
         if (count > maxcount)
            maxcount = count;
      }
      warnx ("%dN %.2d%% %d", bn, 100 * y / gridh, pos);
   }
   writeu32 (pos);
   warnx ("Max per grid %d", maxcount);
   for (postcode_t * p = list; p; p = p->next)
   {
      writeu32 (p->e);
      writeu32 (p->n);
      char pc[8] = { 0 };
      strncpy (pc, p->postcode, sizeof (pc));
      fwrite (pc, 8, 1, stdout);
   }
}
