revk/ESP32-GPS/(commit log)

2019-10-22 Case design
    [Case.scad]
2019-10-22 Hidden SPOX port
    [Case.scad]
2019-10-22 HDOP based speed cut off
2019-10-23 No fix no sunrise
    [GPS.c]
2019-10-24 Sun based on last fix
    [GPS.c]
2019-10-31 Various updates
    [CaseV1.scad, CaseV2.scad]
2019-11-02 Extracting format for fix data
    [GPS.c]
2019-11-02 Basic fixes recorded and compressed
    [GPS.c]
2019-11-02 Missing one on the log
    [GPS.c]
2019-11-03 Encrypted fixes and MQTT logging
    [GPS.c]
2019-11-04 Battery charge state check, not sure it helps
2019-11-04 Track wrap error
2019-11-04 Case for TTGO tracker (very basic for now)
    [CaseTTGO.scad]
2019-11-04 Silly sending all points when quick fix, needs smarter logic
    [GPS.c]
2019-11-05 Logic for no fixes
    [GPS.c]
2019-11-05 Change to message logic to allow clear period covered by each tracking message even when no fixes.
    [GPS.c]
2019-11-06 Avoid double packet at start
    [GPS.c]
2019-11-06 Fix on wifi connect
    [GPS.c]
2019-11-08 Handle new device
2019-11-09 Add TTGO PCB
2019-11-10 Tweak case
    [CaseTTGO.scad]
2019-11-10 Retry power cycle if needed
2019-11-10 Fine tune
    [CaseTTGO.scad]
2019-11-10 Only record valid fixes
    [GPS.c]
2019-11-10 Wrong place USB-C
    [CaseTTGO.scad]
2019-11-11 Auth in devices for sending async messages
2019-11-12 At least one fix per period
    [GPS.c]
2019-11-12 Allow for missing alt
    [GPS.c]
2019-11-14 Tidy PCB a bit
2019-11-15 New device tidy
2019-11-15 Correct drill size
2019-11-15 Track too close
2019-11-15 Library update
    [CaseV2.scad]
2019-11-16 Tweak for DS18B20
    [CaseV2.scad]
2019-11-16 Minor tweaks
    [CaseV2.scad]
2019-11-16 Default ports cleared (various boards in use)
2019-11-18 PCB to take external GPS module
2019-11-19 Missing 1206
    [CaseL86.scad, CaseV2.scad, CaseV4.scad]
2019-11-19 Tweak design
    [CaseL86.scad]
2019-11-19 Fix battery
    [CaseV4.scad]
2019-11-20 More tweaks
    [CaseL86.scad, CaseV4.scad]
2019-11-21 Shape top
    [CaseL86.scad]
2019-11-22 Changed defaults, seems 10Hz fixes loose some features
    [GPS.c]
2019-11-22 Better logging, and fixed EASy setting
    [GPS.c]
2019-11-22 More settings only if needed, as that avoids GPS restart
    [GPS.c]
2019-11-22 Memory tweak for new default fix rate
    [GPS.c]
2019-11-24 New L96 board and case.
    [CaseL96.scad]
2019-11-24 Change for OLED margins
    [CaseV4.scad]
2019-11-26 New case
    [CaseClick.scad]
2019-11-26 After more testing
    [CaseClick.scad]
2019-11-27 Like 10th time lucky maybe, FFS
    [CaseClick.scad]
2019-11-28 DS18B20 added
    [CaseClick.scad]
2019-11-30 Fixed some silly bugs. Seems to be working now
    [GPS.c]
2019-12-01 Maybe we have avoided a tim wrap!
    [GPS.c]
2019-12-04 Try and fix case not fitting quite right
    [CaseClick.scad]
2019-12-05 Various changes to log last location and next fix due...
    [GPS.c]
2019-12-11 PCB for 1551P 40x40x20 box
2019-12-19 Added GPIO0 button
2019-12-20 Allow for thickness of box wall and USB connector clearances
2020-01-08 Screen status based on seeing a fix even if not logging yet
    [GPS.c]
2020-01-26 Fix non UK time zone stuff
    [GPS.c]
2022-03-06 New PCBs started, using KiCad
    [L86-B_Cu.gbr, L86-B_Mask.gbr, L86-B_Paste.gbr, L86-B_Silkscreen.gbr, L86-Edge_Cuts.gbr, L86-F_Cu.gbr, L86-F_Mask.gbr, L86-F_Paste.gbr]
2022-03-06 Stupid drawings
    [L86-B_Cu.gbr, L86-B_Mask.gbr, L86-B_Paste.gbr, L86-B_Silkscreen.gbr, L86-Edge_Cuts.gbr, L86-F_Cu.gbr, L86-F_Mask.gbr, L86-F_Paste.gbr]
2022-03-06 Glider PCB
    [Glider-B_Cu.gbr, Glider-B_Mask.gbr, Glider-B_Paste.gbr, Glider-B_Silkscreen.gbr, Glider-Edge_Cuts.gbr, Glider-F_Cu.gbr, Glider-F_Mask.gbr, Glider-F_Paste.gbr]
2022-03-06 Clean up
    [L86-B_Cu.gbr, L86-B_Mask.gbr, L86-B_Paste.gbr, L86-B_Silkscreen.gbr, L86-Edge_Cuts.gbr, L86-F_Cu.gbr, L86-F_Mask.gbr, L86-F_Paste.gbr]
2022-03-06 Started on Display board.
    [Display.kicad_pcb, Display.kicad_sch, Glider.kicad_pcb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]
2022-03-06 Scrapped old milled board designs, now KiCad based.
    [CaseClick.scad, CaseL86.scad, CaseL96.scad, CaseTTGO.scad, CaseV1.scad, CaseV2.scad, CaseV4.scad]
2022-03-06 Tracked, needs tidying
    [Display.kicad_pcb, Display.kicad_sch]
2022-03-07 New battery holder
    [Display-B_Cu.gbr, Display-B_Mask.gbr, Display-B_Paste.gbr, Display-B_Silkscreen.gbr, Display-Edge_Cuts.gbr, Display-F_Cu.gbr, Display-F_Mask.gbr, Display-F_Paste.gbr]
2022-03-08 3D models
    [Display.kicad_pcb, Display.scad, Display.stl, L86.scad, L86.stl]
2022-03-11 DRC tweaks
    [Display.kicad_pcb, Display.kicad_sch, Glider.kicad_pcb, L86.kicad_pcb]
2022-03-18 Pin names
    [Display.kicad_sch]
2022-03-20 Smaller screws
    [Display-B_Cu.gbr, Display-B_Mask.gbr, Display-B_Paste.gbr, Display-B_Silkscreen.gbr, Display-Edge_Cuts.gbr, Display-F_Cu.gbr, Display-F_Mask.gbr, Display-F_Paste.gbr]
2022-12-31 Broken in v5.0 as owb is broken
    [GPS.c]
2024-01-01 Moved to PCb directory
    [Display.kicad_pcb, Display.kicad_sch, Glider.kicad_pcb, Glider.kicad_sch, L86.kicad_pcb, L86.kicad_sch]
2024-01-01 Moved from SS
    [L86.kicad_pcb, L86.kicad_sch, bom.csv, designators.csv, positions.csv]
2024-01-01 Started update on display.
    [Display.kicad_pcb, Display.kicad_sch]
2024-01-01 Simple logger board
    [Logger.kicad_pcb, Logger.kicad_sch, bom.csv, designators.csv, positions.csv]
2024-01-02 More work
    [Logger.kicad_pcb, Logger.kicad_sch, bom.csv, designators.csv, positions.csv]
2024-01-02 Ready to order
    [Logger.kicad_pcb, Logger.kicad_sch, bom.csv, designators.csv, positions.csv]
2024-01-03 Reverse tantalum FFS
    [Logger.kicad_pcb, Logger.kicad_sch, positions.csv]
2024-01-03 Started on case
    [Logger.kicad_pcb, Logger.scad, Logger.stl]
2024-01-08 Blinking LEDs
2024-01-08 More progress, LEDs
2024-01-09 Odd, was not working as expected
    [GPS.c]
2024-01-10 Reworked, more LEDs, etc
    [Logger.kicad_pcb, Logger.kicad_sch, bom.csv, designators.csv, positions.csv]
2024-01-11 New LED
2024-01-11 LED tweaks
2024-01-12 Tidy LED
2024-01-12 Fix LED and pack
    [GPS.c]
2024-01-17 More caps
    [Logger.kicad_pcb, Logger.kicad_sch, bom.csv, designators.csv, positions.csv]
2024-01-18 Move charger input
    [Logger.kicad_pcb, Logger.kicad_sch]
2024-01-18 RTC pins
    [Logger.kicad_sch]
2024-01-18 Started on 3D
    [L86.scad, L86.stl, Logger.scad, Logger.stl]
2024-01-20 L86 STL
    [L86.scad, L86.stl, Logger.scad, Logger.stl]
2024-01-20 Neater STL
    [L86.scad, L86.stl, Logger.scad, Logger.stl]
2024-01-20 Position adjust
    [L86.kicad_pcb]
2024-01-21 Started on postcode logic
    [ab.csv, al.csv, b.csv, ba.csv, bb.csv, bd.csv, bh.csv, bl.csv]
2024-01-24 Working on power management
2024-01-28 Extra ESD so GPIO0 can be used as a button
    [Logger.kicad_pcb, Logger.kicad_sch, bom.csv, designators.csv, positions.csv]
2024-01-31 Cleaner tracks
    [Logger.kicad_pcb]
2024-01-31 FFS USB not working
    [Logger.kicad_pcb, Logger.kicad_sch]
2024-03-04 Tidy PCB
    [Logger.kicad_pcb, Logger.kicad_sch, bom.csv, positions.csv]
2024-03-16 Documented example plastic case option
    Makes sense to collect links for suitable tested accessories so
    people know what works.
2024-06-30 New headers
    [Logger.kicad_pcb, Logger.kicad_sch, bom.csv, designators.csv, positions.csv]
2025-01-23 PCB Update
    [Display.kicad_pcb, Display.kicad_sch, L86.kicad_pcb, L86.kicad_sch, Logger.kicad_pcb, Logger.kicad_sch]
